BimbaMan/CourseWork3_KSIS_WebLamps/Блочка курсач.pdf

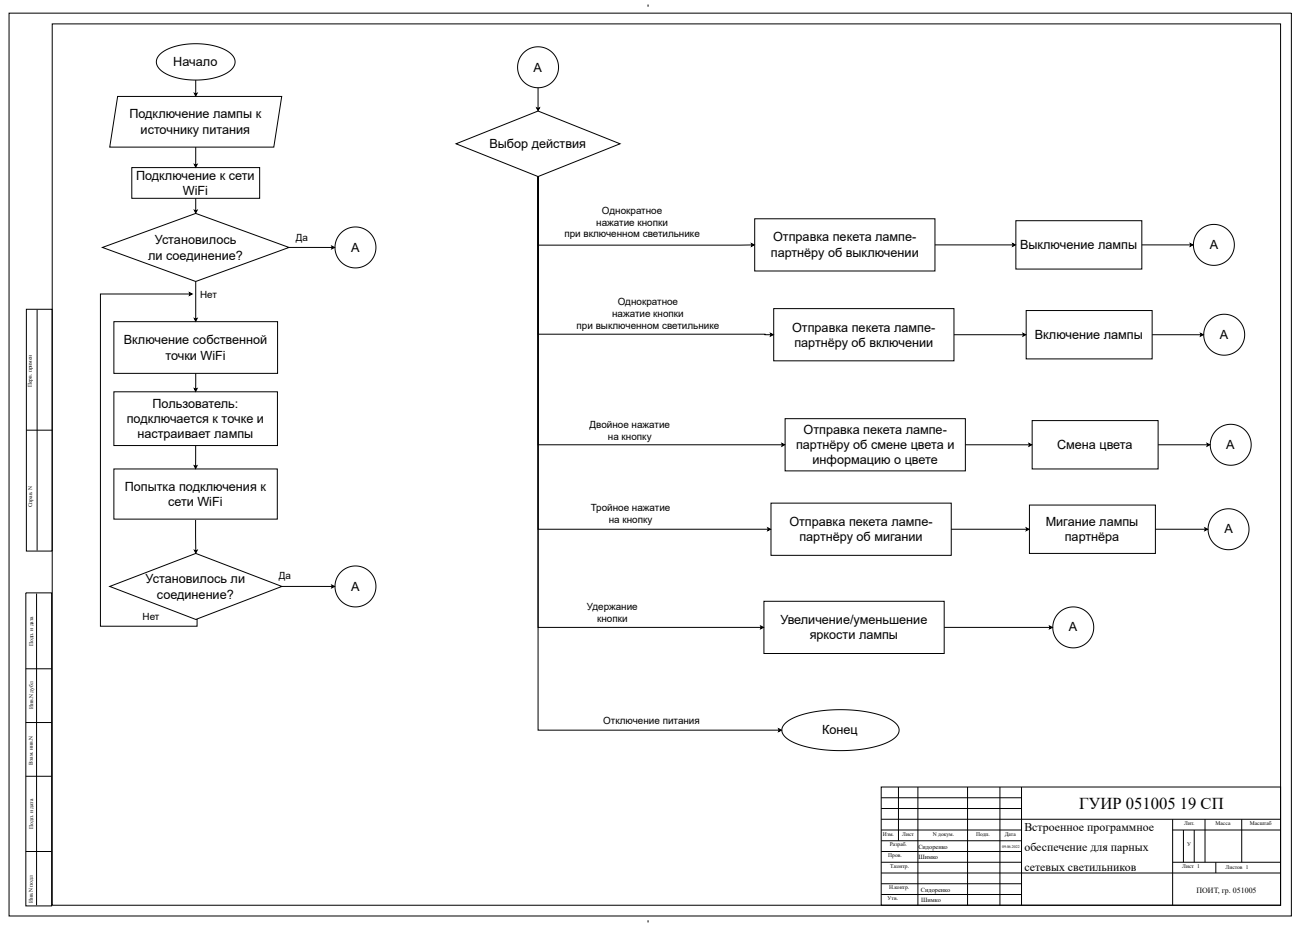
[picture p9: page 1]
под; Под; дата Взам. и; дата С; рав. N; Перв. п; мен; Пров.; Лит.; Разраб.; Масштаб; Лист; Листов; Масса; Т.контр.; Н.контр.; Утв.; Изм.; N докум.; Подп.; Дата; ГУИР 051005 19 СП; ПОИТ, гр. 051005; Сидоренко Шимко; Начало; Подключение лампы к источнику питания; Подключение к сети WiFi; Установилось ли соединение?; Включение собственной точки WiFi; Нет; Пользователь: подключается к точке и настраивает лампы; Попытка подключения к сети WiFi; Выбор действия; Выключение лампы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

Однократное
нажатие кнопки
при включенном светильнике

Отправка пекета лампе-
партнёру об выключении

при выключенном светильнике

партнёру об включении

партнёру об смене цвета и
информацию о цвете

партнёру об мигании

Встроенное программное
обеспечение для парных
сетевых светильников
