BimbaMan/CourseWork3_KSIS_WebLamps/WebLamp/firmware/WebLamp_v1.0/button.ino

void buttonTick() {
  btn.tick();

  // клики
  switch (btn.hasClicks()) {
    case 1:   // вкл выкл
      data.power = !data.power;
      sendPacket();
      memory.update();
      break;
    case 2:   // сменить цвет
      data.color += 32;
      sendPacket();
      memory.update();
      break;
    case 3:   // подмигнуть
      winkFlag = 1;
      sendPacket();
      break;
  }

  // импульсное удержание
  static int8_t dir = 10;
  if (btn.step()) {
    data.bright = constrain(data.bright + dir, 0, 255);
    if (data.bright == 255) {
      FastLED.setBrightness(0);
      FastLED.show();
      delay(150);
      FastLED.setBrightness(255);
      FastLED.show();
      delay(150);
    }
  }
  if (btn.releaseStep()) {
    dir = -dir;
    memory.update();
  }
}
